hahammad01/self-balancing-robot/docs/Complementary vs Kalman logic.docx

### 1. The three numbers (the three lines)

Your firmware prints, each loop: timestamp, accelAngle, gyroAngle, complementaryAngle (and now a 4th, the Kalman). Ignore the timestamp; the three that matter are three different estimates of the same tilt angle:

- accelAngle (blue line) — the tilt worked out purely from gravity, using atan2(ay, az). The accelerometer feels which way "down" is, so this is an absolute angle with no drift — but it's noisy, and it gets fooled by motion (a shake adds fake acceleration).
- gyroAngle (orange line) — the tilt worked out purely by integrating the gyroscope's rotation rate (angle += rate·dt). It's smooth and immune to shaking, but because you're adding up a slightly-biased rate forever, it drifts slowly away from truth.
- complementaryAngle (black line) — the fusion of the two: 98% "gyro (smooth)" + 2% "accel (correct)". It's smooth AND doesn't drift — the best of both.

So all three lines are answering "how tilted is the sensor?" — they just get there three different ways, and the black one is the trustworthy answer.

### 2. What actually changes when you tip it — and why

Here's the key fact: this code measures only ONE axis of tilt, called "roll" — rotation about the sensor's X axis. That's what atan2(ay, az) computes. Your sensor has three axes fixed to the chip:

- X, Y lie flat in the board's plane.
- Z points straight up out of the top (when flat, Z reads +1g, X and Y read ~0).

Now, what each way of tipping does to gravity, and therefore to the number:

You tip it… | Which axis rotates | What gravity does | The number (atan2(ay,az))
Roll (tip one side up, see-saw sideways) | about X | gravity moves from Z → Y (ay grows) | swings to the tilt angle (±40°, etc.) ✅
Pitch (tip front/back) | about Y | gravity moves from Z → X (ax grows, ay stays ~0) | stays ~0 — this code ignores pitch ❌
Yaw (spin it flat on the table) | about Z | gravity stays on Z, nothing moves into X or Y | stays ~0 — no change ❌

Why: atan2(ay, az) only looks at the Y and Z components of gravity. Rolling moves gravity into Y → the formula responds. Pitching moves gravity into X, which the formula doesn't look at → no response. Spinning flat keeps gravity entirely on Z → no response.

So of your "right / left / up / down," only two of them (the two that rotate the board about its X axis) move the graph — one gives + angle, the other gives − angle. The perpendicular pair is pitch, and this code is blind to it. (This is exactly why, earlier, one tilt direction barely moved the number and another swung it — you'd found the pitch axis first, then the roll axis.)

How to identify roll on your board: hold it flat (number ≈ 0), then lift one edge. If the number climbs toward +40°, that edge-lift is +roll; lift the opposite edge → −40°. The two directions that leave the number near 0 are pitch and yaw.

For your balancing robot, you'll mount the IMU so its roll (X) axis lines up with the direction the robot tips over — so this single number is the fall angle the controller needs.

### 3. How the graph depicts a tilt

When you tip about the roll axis and hold it:

- All three lines rise together to a plateau at the angle you're holding. Plateau height = the tilt angle. (In your good run: flat → 0°, tip → plateau at ~−65°, back to 0, tip other way → +50°.)
- Sign tells direction: positive one way, negative the other.
- During the motion, the blue (accel) jumps instantly but noisy, the orange (gyro) slides up smoothly, and the black (fused) rides cleanly between them.
- Over a long hold, the orange line slowly wanders off (drift) while black stays put — that gap is the whole reason fusion exists.

### 4. The Kalman line — same inputs, smarter blending

The Kalman filter (crimson) uses the same accel angle and gyro rate — it just fuses them more cleverly:

- Instead of a fixed 98/2 split, it tracks how uncertain it is and recomputes the accel-vs-gyro weight (the Kalman gain) every step.
- It also estimates the gyro bias live and keeps correcting it, so it stays accurate as the sensor warms up.

Under normal tilts, the Kalman sits right on top of the complementary line — both are correct. The interesting differences only show up under stress (fast shakes), which is where R_measure comes in.

### 5. What changing R_measure taught you

R_measure is one number that means "how noisy do I think the accelerometer is" — i.e. how much should I trust it:

- Low R (0.03): "the accel is reliable" → the Kalman follows the accel closely. Problem: when you shook the sensor, the accel spiked to a false 170–200° (because an accelerometer measures gravity plus motion acceleration — a fast shake adds huge fake acceleration). With low R, the Kalman believed the lie and chased the spike.
- High R (0.1): "the accel is noisy, don't trust it much" → the Kalman leans on the gyro short-term. Now when you shook it, the Kalman rejected the spike and stayed on the true angle (riding with the complementary line).

So the experiment showed you two things:

1. The Kalman gain is tunable, and R_measure is the knob that sets the accel-vs-gyro balance — you watched the same filter go from "accel-follower" to "accel-skeptic" by changing one number.
2. For a robot, higher R (trust the gyro) is safer, because when the robot gets bumped the accel lies exactly like your shake did — and you don't want the estimator to think it's falling when it just got knocked.

That's the complete picture: three ways to measure one tilt angle, a code that reads the roll (X) axis only, a graph whose plateau height is the angle, and two filters whose behavior you can now tune and explain — which is real understanding, not memorized steps
