hahammad01/self-balancing-robot/control/(-ve gyrorate)tilt_plot.png

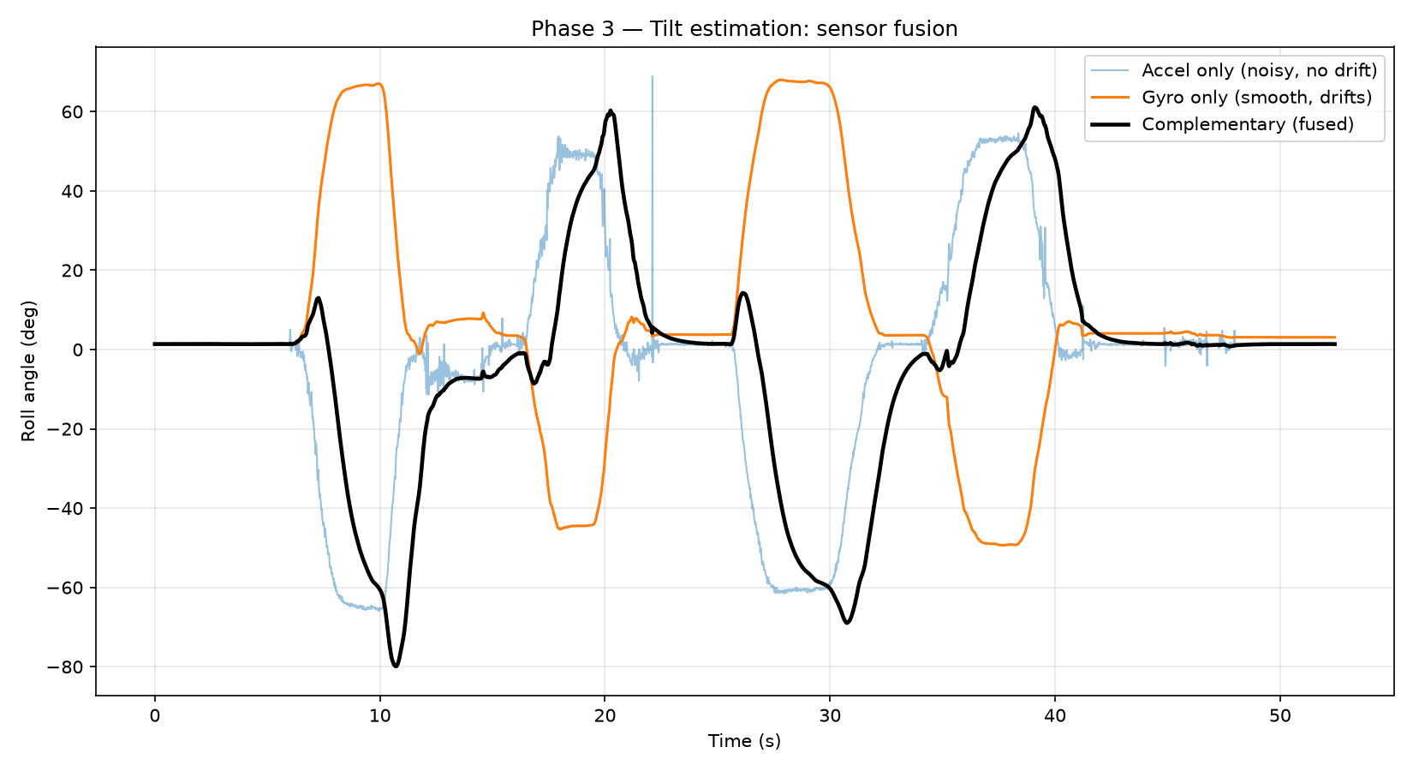
control/(-ve gyrorate)tilt_plot.png
