hahammad01/self-balancing-robot/control/Complementary Filter tilt_plot.png

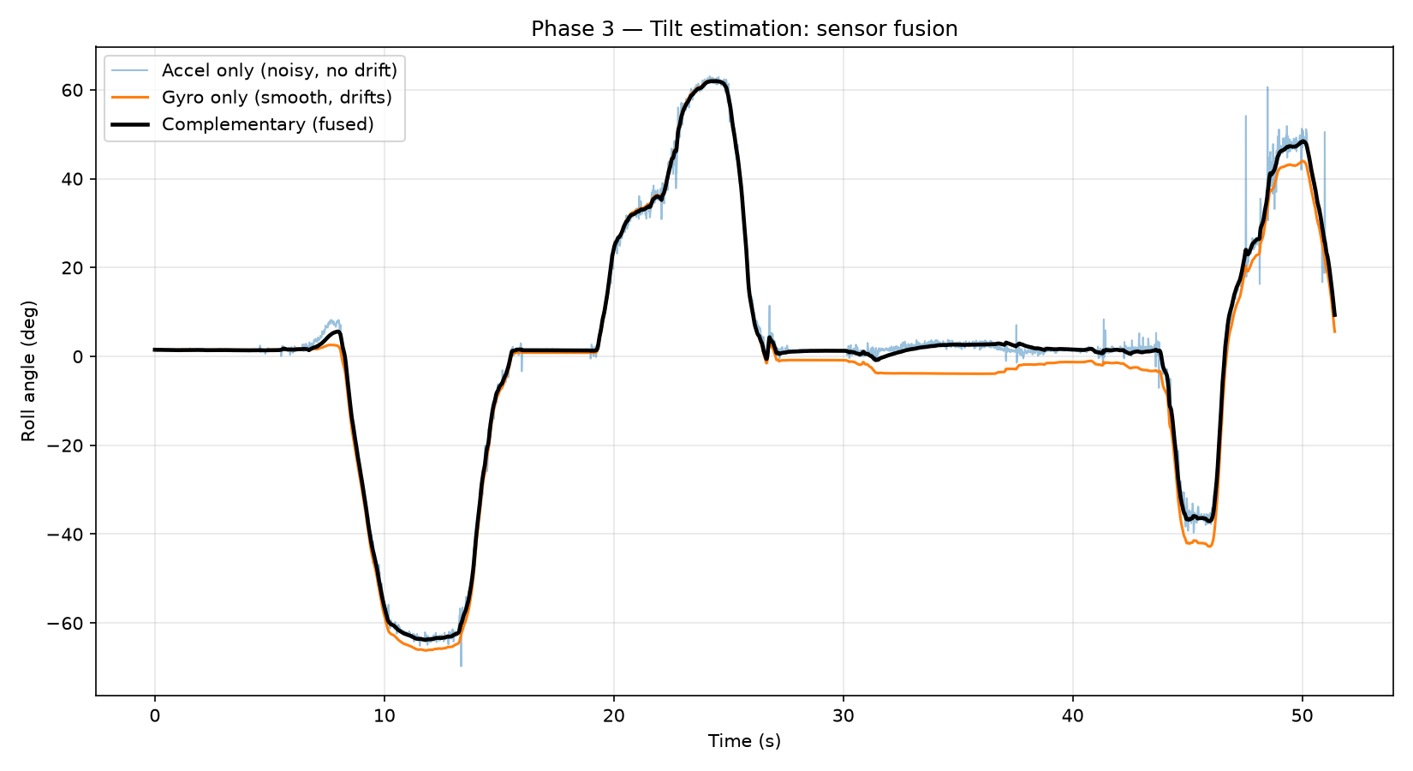
control/Complementary Filter tilt_plot.png
