hahammad01/self-balancing-robot/control/R_measure = 0.1 _tilt_plot.png

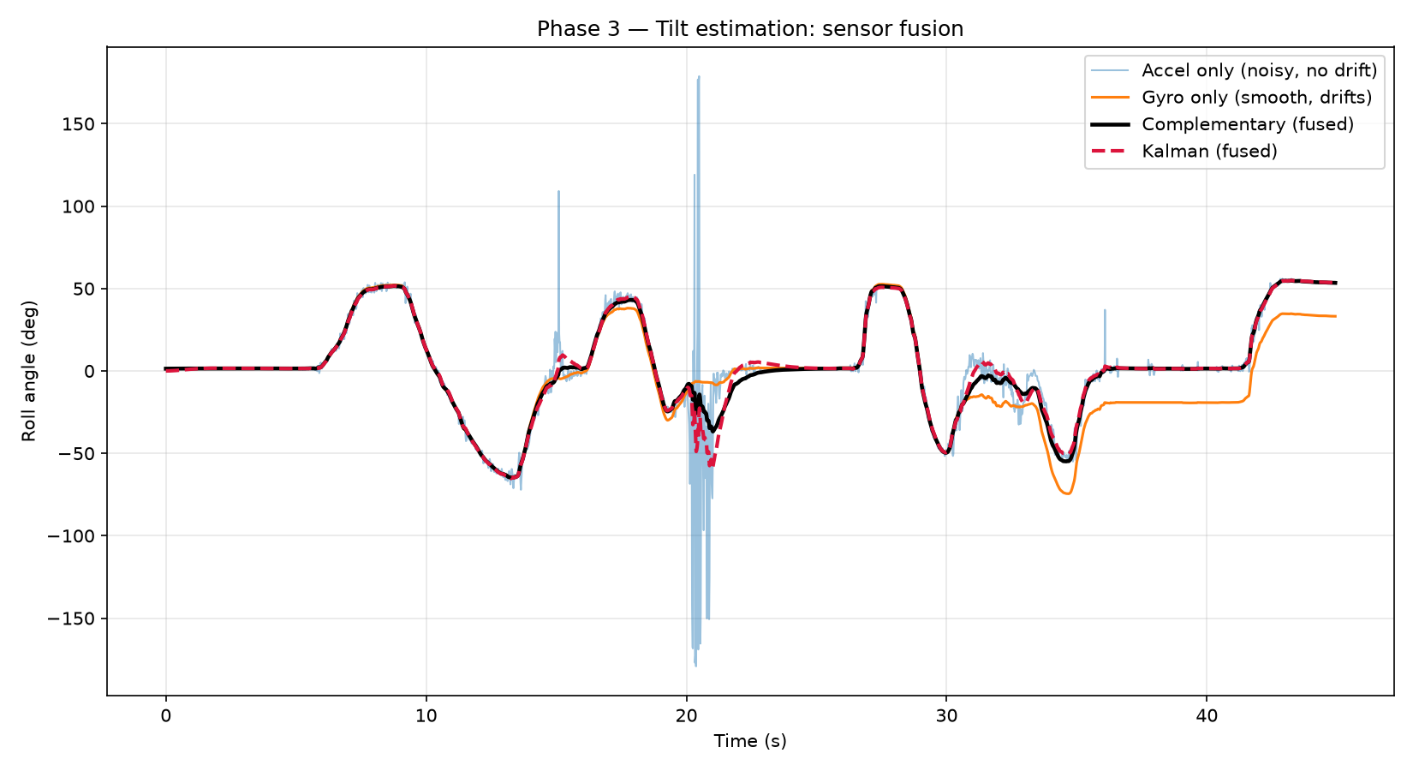
control/R_measure = 0.1 _tilt_plot.png
