hahammad01/self-balancing-robot/control/R_measure = 0.03_tilt_plot.png

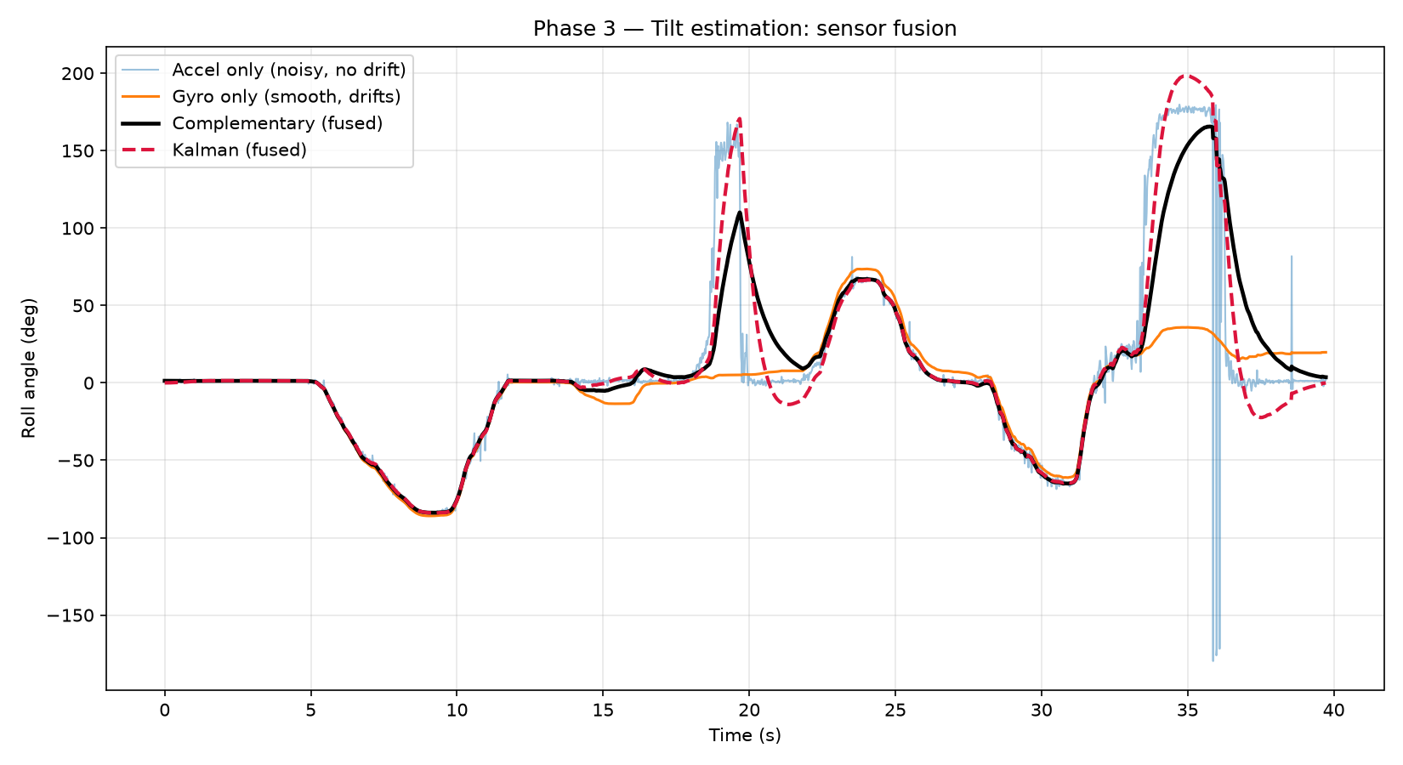
control/R_measure = 0.03_tilt_plot.png
