hahammad01/self-balancing-robot/firmware/phase02_imu/Core/Src/main.c

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
/* Includes ------------------------------------------------------------------*/
#include "main.h"

/* USER CODE BEGIN Includes */
#include <stdio.h>
#include <string.h>
#include <math.h>
/* USER CODE END Includes */

/* USER CODE BEGIN PD */
#define MPU6050_ADDR          (0x68 << 1)  // 7-bit addr 0x68, shifted for HAL (see note)
#define REG_WHO_AM_I          0x75
#define REG_PWR_MGMT_1        0x6B
#define REG_ACCEL_XOUT_H      0x3B
#define REG_GYRO_XOUT_H       0x43
#ifndef M_PI
#define M_PI 3.14159265358979323846f
#endif
/* USER CODE END PD */

I2C_HandleTypeDef hi2c1;

UART_HandleTypeDef huart2;

void SystemClock_Config(void);
static void MX_GPIO_Init(void);
static void MX_I2C1_Init(void);
static void MX_USART2_UART_Init(void);
/* USER CODE BEGIN 0 */
// ---- Kalman filter: 2 states (angle, gyro bias) ----
float Q_angle   = 0.001f;   // process noise on the angle
float Q_bias    = 0.003f;   // process noise on the bias
float R_measure = 0.1f;    // accel measurement noise
float kalAngle  = 0.0f;     // filtered angle (output)
float kalBias   = 0.0f;     // estimated gyro bias (tracked live)
float P[2][2]   = { {0, 0}, {0, 0} };   // uncertainty of [angle, bias]

float kalman(float newAngle, float newRate, float dt) {
    // ---- PREDICT: advance the angle with the gyro, grow the uncertainty ----
    float rate = newRate - kalBias;     // remove the estimated bias
    kalAngle += dt * rate;              // integrate to predict

    P[0][0] += dt * (dt*P[1][1] - P[0][1] - P[1][0] + Q_angle);
    P[0][1] -= dt * P[1][1];
    P[1][0] -= dt * P[1][1];
    P[1][1] += Q_bias * dt;

    // ---- UPDATE: correct with the accelerometer ----
    float S  = P[0][0] + R_measure;     // total expected error
    float K0 = P[0][0] / S;             // Kalman gain for angle
    float K1 = P[1][0] / S;             // Kalman gain for bias

    float y = newAngle - kalAngle;      // innovation: measured - predicted
    kalAngle += K0 * y;                 // correct angle
    kalBias  += K1 * y;                 // correct bias

    float P00 = P[0][0], P01 = P[0][1]; // shrink the uncertainty
    P[0][0] -= K0 * P00;
    P[0][1] -= K0 * P01;
    P[1][0] -= K1 * P00;
    P[1][1] -= K1 * P01;

    return kalAngle;
}
/* USER CODE END 0 */
/**
  * @brief  The application entry point.
  * @retval int
  */
int main(void)
{

  /* MCU Configuration--------------------------------------------------------*/

  /* Reset of all peripherals, Initializes the Flash interface and the Systick. */
  HAL_Init();

  /* Configure the system clock */
  SystemClock_Config();

  /* Initialize all configured peripherals */
  MX_GPIO_Init();
  MX_I2C1_Init();
  MX_USART2_UART_Init();
  /* USER CODE BEGIN 2 */
  // --- variables that must live for the WHOLE program (the loop uses them) ---
  uint8_t who = 0, zero = 0x00;
  uint8_t buf[6];
  char msg[64];
  float roll = 0.0f;        // fused angle (deg) — persists across loops
  float gyroAngle = 0.0f;   // gyro-only angle (deg) — comparison line
  float gxBias = 0.0f;      // gyro-X resting bias (raw counts)
  uint32_t lastTick = 0;
  kalAngle = roll;   // NOTE: roll is still 0 here (it is seeded from the accel further down),
                     // so the Kalman angle starts at 0 deg and converges from the accelerometer.

  // Ask the sensor "who are you?" — 0x68 = MPU6050, 0x70 = MPU6500
  HAL_I2C_Mem_Read(&hi2c1, MPU6050_ADDR, REG_WHO_AM_I, I2C_MEMADD_SIZE_8BIT, &who, 1, 100);

  if (who == 0x68 || who == 0x70) {
      HAL_UART_Transmit(&huart2, (uint8_t*)"MPU6050 found.\r\n", 16, 100);
      HAL_I2C_Mem_Write(&hi2c1, MPU6050_ADDR, REG_PWR_MGMT_1, I2C_MEMADD_SIZE_8BIT, &zero, 1, 100);

      // --- Calibrate gyro bias: KEEP THE SENSOR STILL for ~2 seconds ---
      HAL_UART_Transmit(&huart2, (uint8_t*)"Calibrating - keep still...\r\n", 29, 100);
      int32_t sum = 0;
      for (int i = 0; i < 2000; i++) {
          HAL_I2C_Mem_Read(&hi2c1, MPU6050_ADDR, REG_GYRO_XOUT_H, I2C_MEMADD_SIZE_8BIT, buf, 6, 100);
          sum += (int16_t)((buf[0] << 8) | buf[1]);
          HAL_Delay(1);
      }
      gxBias = sum / 2000.0f;

      // --- Seed the fused angle from the accelerometer ---
      HAL_I2C_Mem_Read(&hi2c1, MPU6050_ADDR, REG_ACCEL_XOUT_H, I2C_MEMADD_SIZE_8BIT, buf, 6, 100);
      int16_t ay0 = (int16_t)((buf[2] << 8) | buf[3]);
      int16_t az0 = (int16_t)((buf[4] << 8) | buf[5]);
      roll = atan2f((float)ay0, (float)az0) * 180.0f / M_PI;
      gyroAngle = roll;
      lastTick = HAL_GetTick();
  } else {
      sprintf(msg, "MPU6050 NOT found (got 0x%02X)\r\n", who);
      HAL_UART_Transmit(&huart2, (uint8_t*)msg, strlen(msg), 100);
  }
  /* USER CODE END 2 */

  /* Infinite loop */
  /* USER CODE BEGIN WHILE */
  while (1)
  {
    /* USER CODE END WHILE */

    /* USER CODE BEGIN 3 */
    // 1) Read accel (absolute angle) + gyro-X (rate)
    HAL_I2C_Mem_Read(&hi2c1, MPU6050_ADDR, REG_ACCEL_XOUT_H, I2C_MEMADD_SIZE_8BIT, buf, 6, 100);
    int16_t ay = (int16_t)((buf[2] << 8) | buf[3]);
    int16_t az = (int16_t)((buf[4] << 8) | buf[5]);
    HAL_I2C_Mem_Read(&hi2c1, MPU6050_ADDR, REG_GYRO_XOUT_H,  I2C_MEMADD_SIZE_8BIT, buf, 6, 100);
    int16_t gx = (int16_t)((buf[0] << 8) | buf[1]);

    // 2) Real elapsed time this loop (seconds)
    uint32_t now = HAL_GetTick();
    float dt = (now - lastTick) / 1000.0f;
    lastTick = now;

    // 3) Accel angle (deg)
    float rollAcc = atan2f((float)ay, (float)az) * 180.0f / M_PI;

    // 4) Gyro rate (deg/s), bias removed
    float gyroRate = (gx - gxBias) / 131.0f;

    // 5) Gyro-only integrated angle (drifts — comparison line)
    gyroAngle += gyroRate * dt;

    // 6) Complementary filter
    float alpha = 0.98f;
    roll = alpha * (roll + gyroRate * dt) + (1.0f - alpha) * rollAcc;
    // Kalman fused angle — uses the SAME bias-corrected gyroRate you fixed
    float rollKalman = kalman(rollAcc, gyroRate, dt);
    // 7) CSV: time_ms, accel, gyro-only, complementary, kalman
    char line[80];
    sprintf(line, "%lu,%.2f,%.2f,%.2f,%.2f\r\n",
            (unsigned long)now, rollAcc, gyroAngle, roll, rollKalman);
    HAL_UART_Transmit(&huart2, (uint8_t*)line, strlen(line), 100);

    HAL_Delay(10);   // 10 ms pause; with the blocking I2C reads and UART print, the logged
                     // runs show a 15-16 ms loop period (~62-67 Hz), not 100 Hz.
  }
  /* USER CODE END 3 */

  /* USER CODE END 3 */
}

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
