hahammad01/self-balancing-robot/(commit log)

2026-09-13 phase2: read MPU6050 over I2C, stream accel+gyro over UART
2026-09-15 phase3: complementary + Kalman tilt estimation, tuned and plotted
    [(-ve gyrorate)tilt_log.csv, Complementary Filter tilt_log.csv, R_measure = 0.03_tilt_log.csv, R_measure = 0.1 tilt_log.csv]
2026-09-23 phase4: open-loop motor drive + encoder feedback (motor A verified)
2026-10-30 docs: repair learning log formatting and correct entries against code and data
    - Remove broken Markdown escaping that rendered as literal backslashes
    - Replace template placeholders with what is actually known
    - Correct the Phase 3 loop-rate, gyro-sign and R_measure claims from the logged CSVs
    - Record real commit hashes, including where firmware was first committed
    - Add Phase 5 in-progress entry
2026-10-30 media: rename bench photos to the phase they show, strip metadata, resize
    'Phase 03.jpeg' showed the Phase 2 raw IMU stream and 'Phase 05.jpeg' showed
    two-motor bench wiring, not Phase 5 results. Re-encoded at 1600 px without EXIF
    (the originals carried GPS coordinates) and with orientation applied.
2026-10-30 firmware(phase02): correct three misleading comments, no code change
    - kalAngle is seeded while roll is still 0, not from the startup accel angle
    - loop period is 15-16 ms in the logged runs, not 100 Hz
    - remove duplicated stale CSV-format comments
    Build output is byte-for-byte the same size (text 22068).
2026-10-30 phase5 (wip): CubeMX project, motor driver module, two-motor encoder test
    168 MHz clock, TIM1 21 kHz PWM, TIM2/TIM3 encoders, TIM6 200 Hz (configured,
    not started), I2C1 400 kHz. motors.c holds the single drive() helper with
    MOTOR_A_SIGN=+1 / MOTOR_B_SIGN=-1. IMU, tilt and PID modules are stubs.
2026-10-30 docs: README status and firmware map, corrected results; IMU identity
    - Phase 5 marked in progress with what is and isn't done
    - Firmware table: phase02_imu holds both Phase 2 and Phase 3
    - Remove claims not supported by the data (same-data comparison, R sweep, overshoot)
    - Repo layout and toolchain describe what exists, planned items marked planned
    - IMU module reports WHO_AM_I 0x70 (MPU6500)
